fatadama/CSCE635/(threads)

Thread 1 (2016-04-19):

Lots of servo jitter with default Arduino Servo library

fatadama, 2016-04-19:
Possible solutions:
Put a cap in the signal circuit
Make sure voltage off Arduino is steady, maybe regulation needed
Use digitalWrite() with a delay, but this is not a favorite option

fatadama, 2016-04-19:
This issue occurred because the SoftwareSerial library was interfering with timers used by the Servo library. Increasing the baud rate reduces the jitter because the time of each read is shorter... I guess. This issue appears to have been resolved by increasing to 57600 baud and disabling all GPS messages except GPRMC messages, which are the only ones used.

Closed 2016-04-19.

Thread 2 (2016-05-03):

Bad readings from GPS

fatadama, 2016-05-03:
We see lots of outliers in GPS data. It seems to occur in all values read from the Venus - I think it's a serial parsing error, probably relating to the perpetual problems with timers. It may not be possible to fix this with the current set up, so we need to be able to reject these outliers. Store the start time and the last time to reject time. Similarly save GPS extrema values and reject any delta of more than a fraction of a degree...?

fatadama, 2016-05-07:
Addressed this by adding GPD checksums.

Closed 2016-05-07.

Thread 4 (2016-05-07):

GPS readings are better than our filter

fatadama, 2016-05-07:
GPS headings seem to have less noise and match our estimates in the mean. We can do better with EKF, but why bother? Make it work before trying to optimize. TODO use the GPS values without offboard processing.

Closed 2016-05-07.
