fatadama/CSCE635/eagle/pixEmilyPdb/pixEmilyPdb.brd

## EAGLE design eagle/pixEmilyPdb/pixEmilyPdb.brd (2016-07-21)

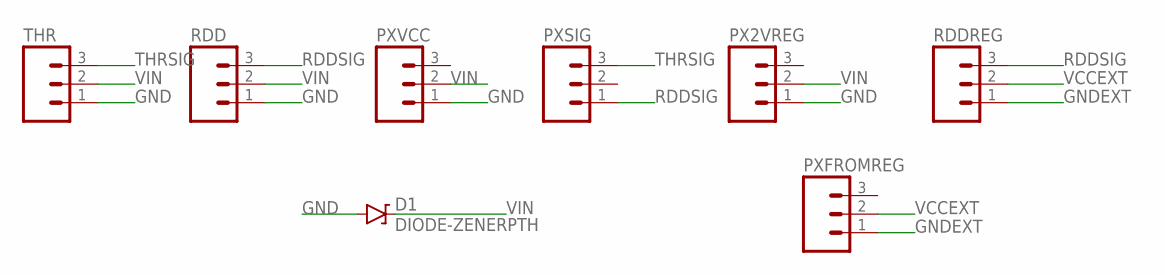
[picture p1: schematic pixEmilyPdb.sch]

Parts:
D1: DIODE-ZENERPTH; DIODE-ZENER
PX2VREG: M03PTH; 1X03
PXFROMREG: M03PTH; 1X03
PXSIG: M03PTH; 1X03
PXVCC: M03PTH; 1X03
RDD: M03PTH; 1X03
RDDREG: M03PTH; 1X03
THR: M03PTH; 1X03

Connections:
GND: D1.P$2 (A), PX2VREG.1, PXVCC.1, RDD.1, THR.1
GNDEXT: PXFROMREG.1, RDDREG.1
RDDSIG: PXSIG.1, RDD.3, RDDREG.3
THRSIG: PXSIG.3, THR.3
VCCEXT: PXFROMREG.2, RDDREG.2
VIN: D1.P$1 (C), PX2VREG.2, PXVCC.2, RDD.2, THR.2

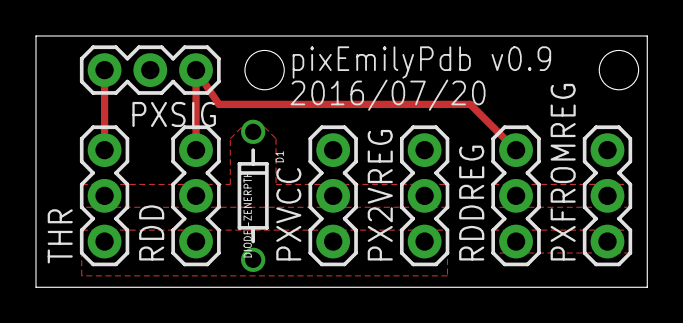
[picture p2: board pixEmilyPdb.brd from above]

Board: 2 copper layers, 34.0 x 14.0 mm, 8 parts (0 on the bottom side), 6 nets.
