fatadama/CSCE635/eagle/emilyCircuit/emilyBoard.brd

## EAGLE design eagle/emilyCircuit/emilyBoard.brd (2016-07-17)

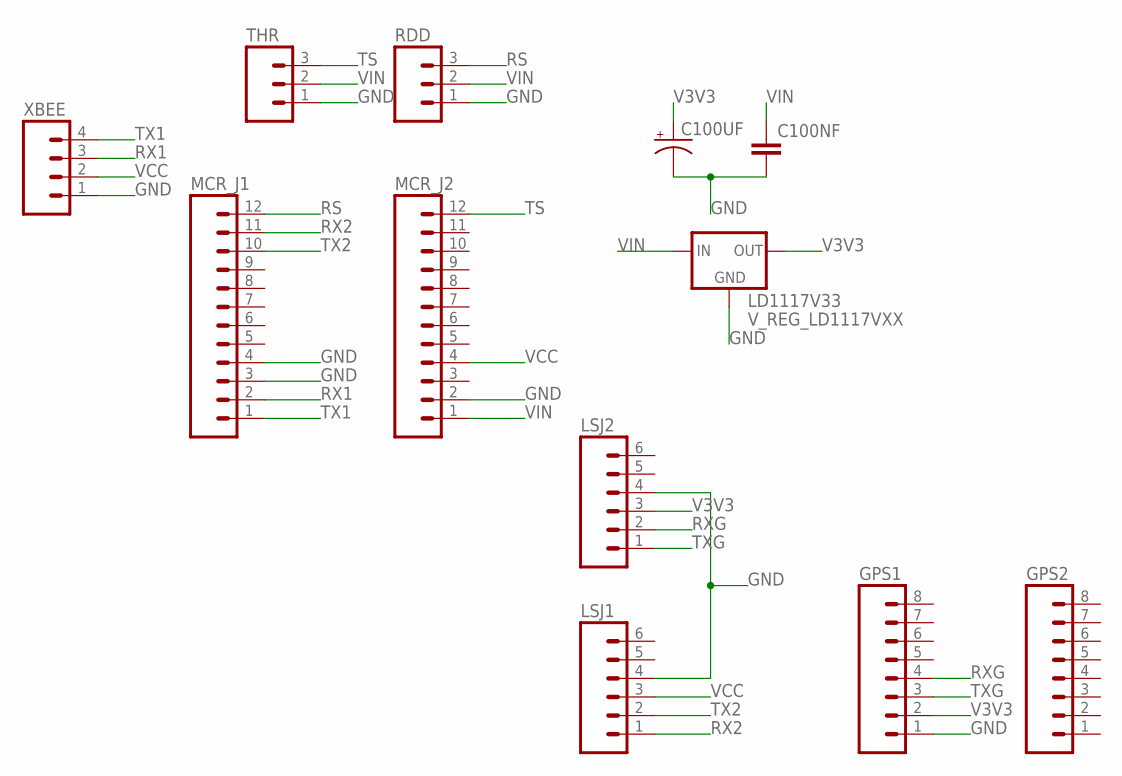
[picture p3: schematic emilyBoard.sch]

Parts:
C100NF: CAPEZ; CAP-PTH-SMALLEZ
C100UF: CAP_POLPTH1; CPOL-RADIAL-100UF-25V
GPS1, GPS2: M08; 1X08_ROUND
LD1117V33: V_REG_LD1117VXX; 78XXL
LSJ1, LSJ2: M06NO_SILK_FEMALE_PTH; 1X06_NO_SILK
MCR_J1, MCR_J2: M12PTH; 1X12
RDD: M03PTH; 1X03
THR: M03PTH; 1X03
XBEE: M04PTH; 1X04

Connections:
GND: C100NF.2, C100UF.2 (-), GPS1.1, LD1117V33.IN (GND), LSJ1.4, LSJ2.4, MCR_J1.3, MCR_J1.4, MCR_J2.2, RDD.1, THR.1, XBEE.1
RS: MCR_J1.12, RDD.3
RX1: MCR_J1.2, XBEE.3
RX2: LSJ1.1, MCR_J1.11
RXG: GPS1.4, LSJ2.2
TS: MCR_J2.12, THR.3
TX1: MCR_J1.1, XBEE.4
TX2: LSJ1.2, MCR_J1.10
TXG: GPS1.3, LSJ2.1
V3V3: C100UF.1 (+), GPS1.2, LD1117V33.GND (OUT), LSJ2.3
VCC: LSJ1.3, MCR_J2.4, XBEE.2
VIN: C100NF.1, LD1117V33.OUT (IN), MCR_J2.1, RDD.2, THR.2

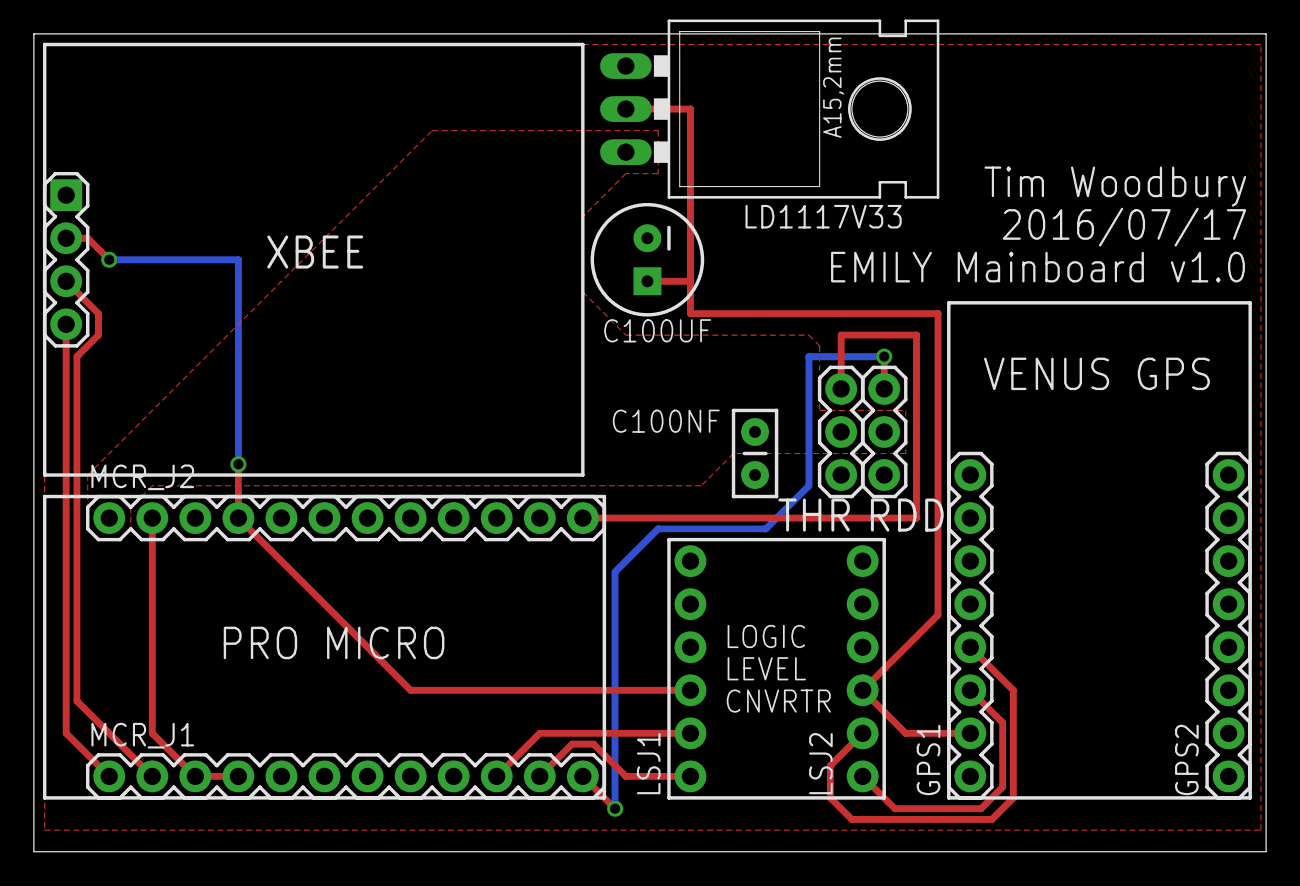
[picture p4: board emilyBoard.brd from above]

Board: 2 copper layers, 72.7 x 48.2 mm, 12 parts (0 on the bottom side), 12 nets.
