fatadama/CSCE635/arduino/emilyControl/emilyControl.cpp

#include "emilyControl.h"
#include <stdint.h>

uint16_t scale_pwm(float val,float low, float high){
  return uint16_t ( (1000.0*(val+high)-2000.0*low)/(high-low) );
}

//x = ((low-val)*2000+(val-high)*1500)/(low-high)
uint16_t scale_pwm_throttle(float val, float low, float high){
  return uint16_t ( ((low-val)*2000.0+(val-high)*1500.0)/(low-high) );
}

emilyControl::emilyControl(){
  new_value = 0;
  millis_last = 0;
  // initialize the PID gain
  rudder_pid.set_Kp(0.0);
  rudder_pid.set_Ki(0.0);
  rudder_pid.set_Kd(0.0);
  rudder_pid.set_integral_max(0.1);
  throttle_pid.set_Kp(0.0);
  throttle_pid.set_Ki(0.0);
  throttle_pid.set_Kd(0.0);
  throttle_pid.set_integral_max(0.1);
  // initialize the lowpass objects for the throttle and rudder commanded
  throttle.set_alpha(0.025);
  rudder.set_alpha(0.025);
}

void emilyControl::misc_tasks(uint32_t millis,emilyStatus status){
  // check the time
  if (millis - millis_last > EMILYCONTROL_RATE_MILLIS){
    millis_last = millis;
    if (status.control_mode == CONTROL_MODE_PASSIVE){ // do nothing
      // write out zeros
      throttle.update(0.0);
      rudder.update(0.0);
    }
    if (status.control_mode == CONTROL_MODE_DIRECT){ //offboard control
      // read from status object
      throttle.update(status.control_throttle);
      rudder.update(status.control_rudder);
    }
    /*
    if (status.control_mode == CONTROL_MODE_INDIRECT){ // automatic control
      // set the gains if new values
      // check if the GPS data are new
      // copy local GPS
      // perform smoothing or estimation
      // compute PID control
      // not implemented yet: write out zeros
      throttle.update(0.0);
      rudder.update(0.0);
    }*/
    // FLAG that there is new data in the control object
    new_value = 1;
  }
}

void emilyControl::get_pwm(uint16_t* pwm_rudder,uint16_t* pwm_throttle){
  // map rudder to (1000,2000)
  *pwm_rudder = scale_pwm(rudder.get_x(),-1.0,1.0);
  // NEW specific mapping for throttle from (1500,2000)
  *pwm_throttle = scale_pwm_throttle(throttle.get_x(),0.0,1.0);
  // FLAG that the control value has been accessed
  new_value = 0;
}

uint8_t emilyControl::new_control(){
  return new_value;
}
