fatadama/CSCE635/(commit log)

2016-04-14 Added low pass filter object for smoothing control signals from ground. TODO use this class to update the GPS processing. TODO read heading and speed from GPS GPRMC messages
2016-04-15 Broke out low pass filter class into own source code. Added test function to validate that PID seems to be working correctly.
2016-04-16 There's some kind of error or memory leak in emily_driver. It causes the system to fail (stop transmitting debug messages) after a short amount of time when the PWM writing and XBee communications ar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
    [emilyGPS_set_settings.ino, emily_driver.ino]
2016-04-17 Updated the emilyControl object to no longer use the global status object - it just uses a local copy in the misc_tasks() function
    [emily_driver.ino]
2016-04-17 Removed the global status pointer from the commParser class. TODO resolve issues with GPS data getting garbled at fast sample rates.
    [emily_driver.ino]
2016-04-17 Something is not working right. Apparently the commParser bitstring is not getting set.
    [emily_driver.ino]
2016-04-17 Added a serial debugging script for reading debugging output from the Arduino when it's on USB0
2016-04-18 There's some bitshifting error associated with how the 32 bit ints are packed in ESP. Using memcpy() seems to fix it. TODO change all such in ESP to memcpys
    [emily_driver.ino, espmodule.cpp, serial_test_debugging.py]
2016-04-18 Modified debug output from Arduino to be more parseable and added logging to serial_debugging python code Finished converting all ESP int32_t packs into memcpy() calls Added a test file for using cur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
    [curses_test.py, emily_driver.ino, serial_test_debugging.py]
2016-04-18 Added servo objects to the main driver to replace analogWrite() calls. Untested on servos yet.
    [emily_driver.ino]
2016-04-18 Updated serial debugging function to do error checking if board is not connected over USV|B
    [serial_test_debugging.py]
2016-04-19 Switched back to using old ESP library writen in python for simplicity. Newer C++ extension still exists in folder EPS
2016-04-19 Started adding messages to the python ESP. Have not tested with C++/Arduino yet, TODO
2016-04-19 Finished adding ESP functions to python version. Tested that GPS and control are received by Arduino
2016-04-19 Modified emily_driver to disble all GPS messages except GPRMC types. Increased SoftwareSerial baud rate to 57k. Servo jitter seems acceptably low at this rate. Added serial_control_test.py python scr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
    [emily_gps_driver.ino, emily_servo_driver.ino, serial_control_test.py, serial_test_debugging.py]
2016-04-25 Fixed bug in commParser; compiles Modified emilyControl to map throttle from 1500 to 2000 ms. (Apprently the motor reverses) Modified python control test script to write throttle values on w/s keys
    [emily_driver.ino, serial_control_test.py]
2016-04-30 Reduced the lowpass filter 'alpha' values from 0.1 to 0.05
2016-04-30 Reduced lowpass filter value
2016-05-04 Added a zero-jerk filter and tuned using histogram. Looks reasonable, hard to validate. Heading matches GPS output, but not velocity.
2016-05-04 Modified filter2 file to write to file
2016-05-04 Added logs from 4-30 to the repository
    [controlLog.csv, controlOutLog.csv, gpslog.csv, jerkOut.csv]
2016-05-04 Added hardware_interface class for talking to an Xbee. Provides UDP for software-in-loop testing with the same interface. Validated with test programs. Wrote emilyEcho program to print any messages r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
2016-05-05 Added simple keyboard input if there's no joystick, for debugging mostly Added logging Broken the message handling in xbee_bridge_process into its own function Added control_mode flag Added some comm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
    [hardware_interface.py, joystick.py, xbee_bridge.py]
2016-05-05 Added logging of serial messages in espParser object, tested. Fixed an issue in the parser that might have been causing it to throw away some bytes when it shouldn't have, but I'm not sure if this ha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
    [esp_python.py, xbee_bridge.py]
2016-05-05 Added settings file to set the comm port of the XBee and toggle SIL mode on/off. Validated parser. Fixed bug in hardware_interface object
    [hardware_interface.py, settings.ini, xbee_bridge.py]
2016-05-05 Added bassic control object to xbee_bridge suite. Need to add PID and incorporate with main code
2016-05-05 Added PID class from old Crazyflie files Creates a log Added control object to main xbee_bridge process but did not test yet
2016-05-06 Some random hacks to try to reject GPS correctly on the ground side
    [filter_dynamics.py, xbee_bridge.py, xbee_bridge_state.py]
2016-05-06 Changed GPS stream rate to 10 Hz
2016-05-06 Fixed a bug where the GPS velocity and heading were getting rescaled twice, causing bad unit outputs.
2016-05-06 Added logging to synethetic waypoint Misc bugfixed from testing Modified settings
    [control.py, settings.ini, xbee_bridge.py, xbee_bridge_state.py]
2016-05-06 Modified automatic control mode. EMILY will turn on the throttle until a smoothed average of throttle exceeds a threshold of 0.25, THEN will create synthetic waypoint. This is supposed to make the he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
2016-05-07 Bug fix from testing
    [emily_driver.ino]
2016-05-07 Added checksum parsing to GPS messages. Tested in Arduino file emily_gps_checksum. TODO integrate with main code and confirm.
2016-05-07 Modified pfields mode significantly. When triggered, a fixed-action pattern of five second throttle-on is engaged to get the heading. We record position at the start and end of this mode as a backup 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
    [control.py, xbee_bridge.py]
2016-05-07 Modified xbee_bridge_state to use the GPS speed and heading directly without filtering. GPS heading seems to be better than the lowpassed approximations were.
2016-05-20 Added EAGLE drawings of the basic circuit for PCB
    [emilyBoard.brd, emilyBoard.sch]
2016-05-23 Added connections to emily board
    [emilyBoard.brd]
2016-07-17 Updated EMILY PCB files with labels. Complies with OSHPark DRGs and Eagle ERGs.
    [emilyBoard.brd, emilyBoard.sch]
2016-07-20 Added power distribution board for EMILY using Pixhawk
    [pixEmilyPdb.brd, pixEmilyPdb.sch]
2016-07-21 Updated PBD with mounting holes & misc fixes
    [pixEmilyPdb.brd]
